crlab3/OBD_IONRF_ESP32/OBDESP/OBDESP.dxf

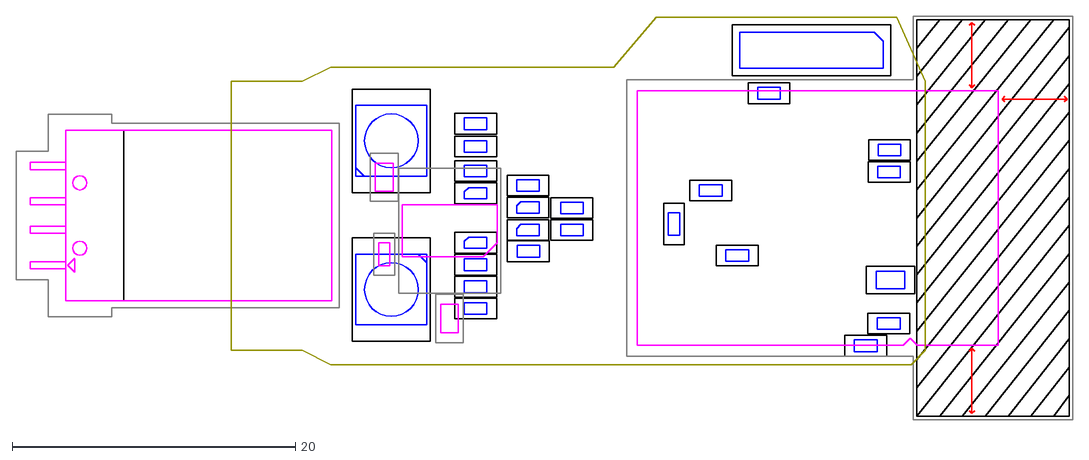
[picture p1: CAD file, 2022-12-18]
OBDESP/OBDESP.dxf
74.6 x 28.5
