crlab3/OBD_IONRF_ESP32/Manufacturing.xlsx

Sheet: ESP32-OBD
Tétel neve | Szükséges darabszám | Forrás | Link | Ár (nettó) | Ár (bruttó) | Szállítási díj
Alapalkatrészek | 1 | LOMEX |  |  | 2500 | 2200
ELM327 OBD olvasó | 1 | Peppi.hu | https://peppi.hu/products/obd2-hibakod-olvaso?variant=6866871943229&currency=HUF |  | 3400 | 2000
USB Szivargyújtó töltő | 1 | Aqua.hu | https://aqua.hu/mobiltelefon-kiegeszito/baseus-grain-autos-tolto-2x-usb-31a-fekete-ccall-ml01-t1167436 |  | 1220 | 2000
ESP32-WROOM Modul | 1 | Mouser | https://hu.mouser.com/ProductDetail/Espressif-Systems/ESP32-WROOM-32E-H4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 |  | 1340 | 1000
Nyomtatott áramköri lap | 1x6 | Aisler | Aisler.net - Blitz, UPS standard |  | 1700 | 5600
USB-ház (Hammond) | 1 | Mouser | https://hu.mouser.com/ProductDetail/Hammond-Manufacturing/1551USB3CLR?qs=UqPySVGgRwHUcGN5q%252B3ujQ%3D%3D |  | 1250 | 2000
 |  |  |  |  | 68460 | 14800
 |  |  |  |  | 6 db teljes ára | ár/db (6 db-ra vetítve) | 30 db ára
 |  |  |  |  | 83260 | 13876.66667 Ft | 357100
 |  |  |  | Munkadíj | 10000 Ft | 10000 Ft

Sheet: ESP32-OBD with IO-NRF
Tétel neve | Szükséges darabszám | Forrás | Link | Ár (nettó) | Ár (bruttó) | Szállítási díj
Alapalkatrészek | 1 | LOMEX |  |  | 2500 | 2200
ELM327 OBD olvasó | 1 | Peppi.hu | https://peppi.hu/products/obd2-hibakod-olvaso?variant=6866871943229&currency=HUF |  | 3400 | 2000
USB Szivargyújtó töltő | 1 | Aqua.hu | https://aqua.hu/mobiltelefon-kiegeszito/baseus-grain-autos-tolto-2x-usb-31a-fekete-ccall-ml01-t1167436 |  | 1220 | 2000
ESP32-WROOM Modul | 1 | Mouser | https://hu.mouser.com/ProductDetail/Espressif-Systems/ESP32-WROOM-32E-H4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 |  | 1340 | 1000
Nyomtatott áramköri lap | 1x6 | Aisler | Aisler.net - Blitz, UPS standard |  | 1700 | 5600
USB-ház (Hammond) | 1 | Mouser | https://hu.mouser.com/ProductDetail/Hammond-Manufacturing/1551USB3CLR?qs=UqPySVGgRwHUcGN5q%252B3ujQ%3D%3D |  | 1250 | 2000
NRF24L01 | 1 | techfun.sk | NRF24L01 (6 db) |  | 757 | 1915
 |  |  |  |  | 73002 | 16715
 |  |  |  |  | 6 db teljes ára | ár/db (1 db-ra vetítve) | 30 db-ra
 |  |  |  |  | 89717 | 14952.83 Ft | 381725
 |  |  |  | Munkadíj | 10000 Ft | 10000 Ft

Sheet: IO-NRF_minimal (6 db)
Tétel neve | Szükséges darabszám | Forrás | Link | Ár (nettó) | Ár (bruttó) | Szállítási díj
Alapalkatrészek | 1 | LOMEX | Mindenből 5 helyett 6 db a tartalék miatt. | 6936 | 8808.72 | 2200
Alapalkatrészek | 1 | Mouser.com | AP7370-33W-7, 556-ATTINY84-20SSUR |  | 6238 | 1500
NRF24L01 + XKC-Y25-NPN | 1 | techfun.sk | NRF24L01 + XKC-Y25-L01 |  | 37185 | 0
NRF24L01 + XKC-Y25-NPN | 1 | eBay | NRF24L01 (4767 Ft) + XKC-Y25-NPN (21600 Ft) |  | 26366 | 0
NRF24L01 + XKC-Y25-NPN | 1 | TechFun.sk, HEStore | NRF24L01 (4540 Ft) + XKC-Y25-NPN (24000 Ft) |  | 28540 | 1915
Nyomtatott áramköri lap | 1 x 6PCs | Aisler (Budget) | Aisler.net |  | 5127 | 0
Nyomtatott áramköri lap | 1 x 6PCs | Aisler (Blitz) | Aisler.net |  | 10254 | 5530
Inline Blade Fuse Holder | 1 | FDH | Multicomp MP001005 + TLP291 | 12332 | 15661.64 | 0
 |  |  |  |  |  |  | ár/db | ár/db | ár/db 30 db-ra
 |  |  |  |  |  |  | 2-hét alatt (Aisler Blitz) | 4-hét alatt (Aisler Budget) | 2-hét alatt (Aisler Blitz)
 |  |  |  |  |  |  | 13441.2 Ft | 11665.1 Ft | 11955.2 Ft
 |  |  |  |  |  | Munkadíj | 10000 Ft | 10000 Ft

Sheet: Beültetési árak
Név | Darabszám | Gyártó | Méret | Ajánlott ár | Ajánlott ár/db | EUR2HUF | Ár/db | Végösszeg
22 SMT, 13 Unique, Single sided
IO-NRF minimal (THT) | 30 | Aisler | 52x33 | 267.55 € | 8.92 € | 395.0 Ft | 3522.7 Ft | 105682.2 Ft
IO-NRF minimal (NO-THT) | 30 | Aisler | 52x33 | 161.55 € | 5.39 € | 395.0 Ft | 2127.1 Ft | 63812.3 Ft
35 SMT, 21 Unique, Double sided
OBDESP32 (NOTHT) | 30 | Aisler | 57x26 | 340.89 € | 11.36 € | 395.0 Ft | 4488.4 Ft | 134651.6 Ft
OBDESP32 (NOTHT) | 20 | Aisler | 57x26 | 323.93 € | 16.20 € | 395.0 Ft | 6397.6 Ft | 127952.4 Ft
OBDESP32 (NOTHT) | 10 | Aisler | 57x26 | 306.96 € | 30.70 € | 395.0 Ft | 12124.9 Ft | 121249.2 Ft

Sheet: Összesítő 30 db
Tétel név | Alkatrészek + NYÁKgyártás | Beültetés (AISLER, EUR) | Beültetés (AISLER, HUF) | EUR2HUF | Végösszeg (beültetéssel) | Végösszeg/db (beültetéssel) | Végösszeg (beültetés nélkül) | Végösszeg/db (beültetés nélkül)
IO-NRF minimal | 358656.6 Ft | 161.55 € | 63812.25 Ft | 395 | 422468.85 Ft | 14082.30 Ft | 358656.6 Ft | 11955.22 Ft
OBD-ESP32 with IO-NRF | 381725.0 Ft | 340.89 € | 134651.55 Ft | 395 | 516376.55 Ft | 17212.55 Ft | 381725.0 Ft | 12724.17 Ft
OBD-ESP32 only | 357100.0 Ft | 340.89 € | 134651.55 Ft | 395 | 491751.55 Ft | 16391.72 Ft | 357100.0 Ft | 11903.33 Ft
darabszám | 30
