crlab3/OBD_IONRF_ESP32/IO_NRF_minimal/IO_NRF_minimal.kicad_pcb

## KiCad design IO_NRF_minimal/IO_NRF_minimal.kicad_pcb (2023-07-27)

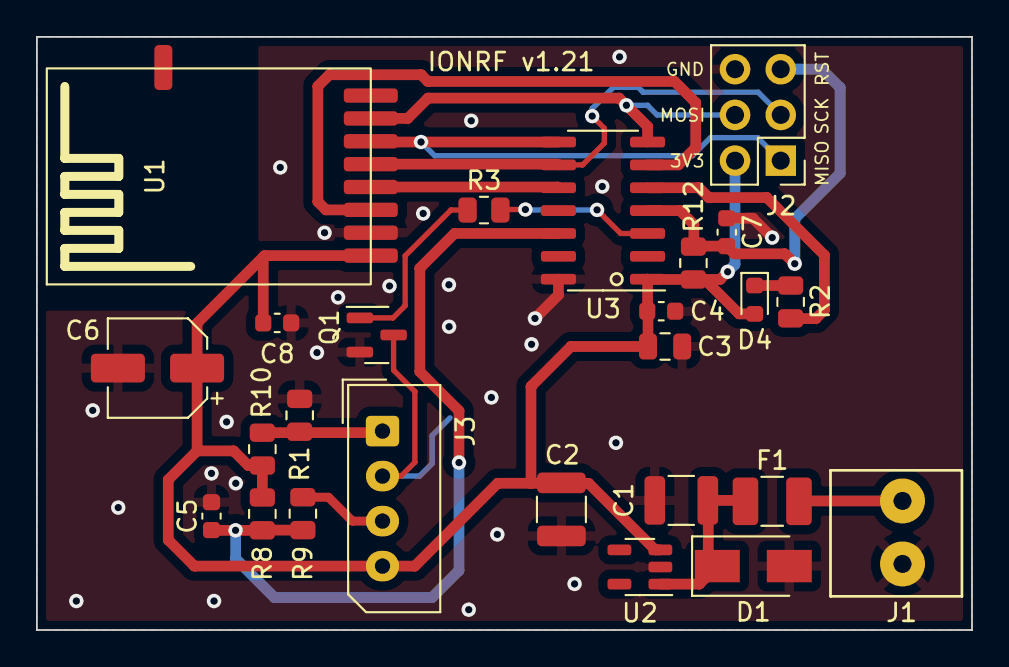
[picture p2: board IO_NRF_minimal.kicad_pcb from above]

Board: 2 copper layers, 52.0 x 33.0 mm, 26 parts (1 on the bottom side), 18 nets.

Parts:
C1, C2: 10uF; C_1210_3225Metric
C3: 4.7uF; C_0805_2012Metric
C4, C5, C7, C8: 100nF; C_0603_1608Metric
C6: 100uF; CP_Elec_5x5.3
D1: DO-214AC; D_SMA
D4: LED; LED_0603_1608Metric
F1: 100mA Polyfuse; Fuse_1210_3225Metric_Pad1.42x2.65mm_HandSolder
J1: 12V_IN; SORKAPOCS-3.5mm-2
J2: Programmer_Pins_SPI; PinHeader_2x03_P2.54mm_Vertical
J3: XKC-Y2S-IN; Molex_SPOX_5267-04A_1x04_P2.50mm_Vertical
JP1: SolderJumper_2_Open; SolderJumper-2_P1.3mm_Open_RoundedPad1.0x1.5mm
Q1: BC847B; SOT-23
R1, R2, R3, R8, R9, R10, R12: 1k; R_0805_2012Metric
U1: NRF24L01_SMD
U2: AP7370-33WW-7; SOT-23-5
U3: ATtiny84-20SS; SOIC-14_3.9x8.7mm_P1.27mm

Connections:
/3V3: C2.1, C3.1, C4.1, C6.1, C8.2, D4.2 (A), J2.2, J3.4, R8.1, R10.1, R12.1, U1.1 (3V3), U2.3 (VOUT(3.3V)), U3.1 (VCC)
/ACC_12V_IN: F1.2, J1.2
/ACC_12V_PROT: C1.1, D1.1 (K), F1.1, U2.1 (VIN)
/MCU_MISO: J2.1, U1.6 (MOSI), U3.8 (PA5)
/MCU_MOSI: J2.4, U1.7 (MISO), U3.7 (PA6)
/MCU_RESET: C7.2, J2.5, R12.2, U3.4 (~RESET/PB3)
/MCU_SCK: J2.3, U1.5 (SCK), U3.9 (PA4)
/NRF_CE: U1.3 (CE), U3.6 (PA7)
/NRF_CS: U1.4 (CSN), U3.10 (PA3)
/XKC-Y2S-IN: C5.2, R8.2, R9.2, U3.12 (PA1)
/XKC_ACTIVATE: R3.2, U3.3 (XTAL2/PB1)
GND: C1.2, C2.2, C3.2, C4.2, C5.1, C6.2, C7.1, C8.1, D1.2 (A), J1.1, J2.6, JP1.1 (A), Q1.2 (E), R1.1, U1.2 (GND), U2.2 (GND), U3.14 (GND)
unnamed: D4.1 (K), R2.1
unnamed: J3.1, R1.2, R10.2
unnamed: J3.2, JP1.2 (B), Q1.3 (C)
unnamed: J3.3, R9.1
unnamed: Q1.1 (B), R3.1
unnamed: R2.2, U3.5 (PB2)
