crlab3/OBD_IONRF_ESP32/OBDESP/OBDESP.kicad_pcb

## KiCad design OBDESP/OBDESP.kicad_pcb (2023-07-27)

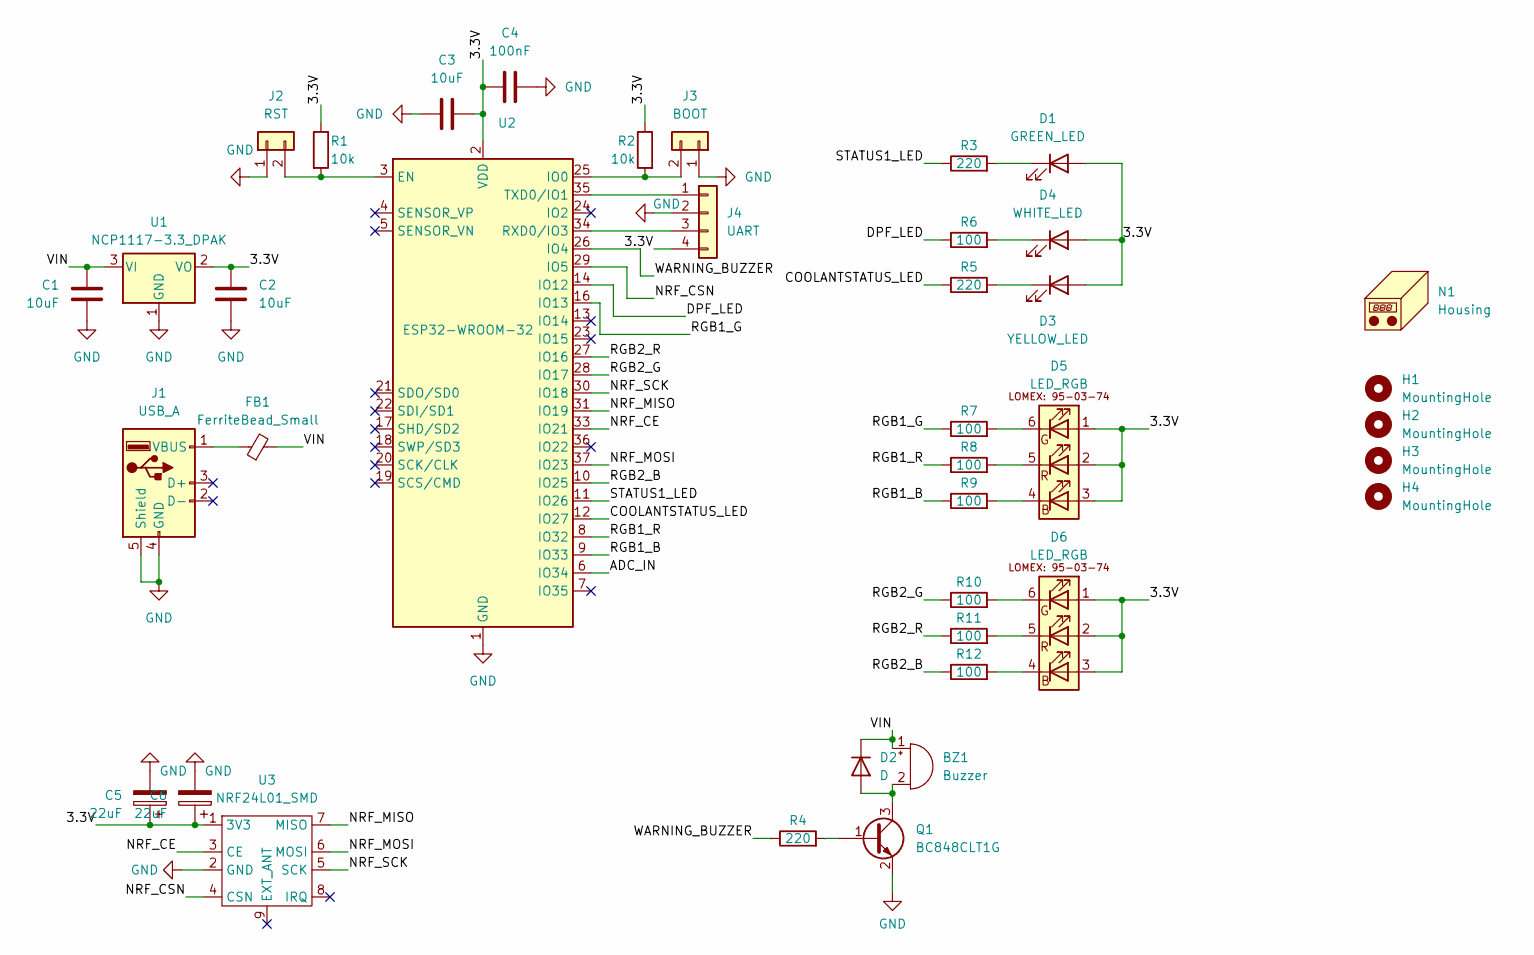
[picture p3: schematic OBDESP.kicad_sch]

Parts:
BZ1: Buzzer; PUIAudio_SMT_0825_S_4_R; Mouser 490-CMT-7525-80SMTTR
C1, C2, C3: 10uF; C_0805_2012Metric
C4: 100nF; C_0603_1608Metric
C5, C6: 22uF; CP_EIA-3216-18_Kemet-A
D1: GREEN_LED; LED_0603_1608Metric
D2: D; D_SMA
D3: YELLOW_LED; LED_0603_1608Metric
D4: WHITE_LED; LED_0603_1608Metric
D5, D6: LED_RGB; LED_RGB_5050-6
FB1: FerriteBead_Small; L_0603_1608Metric
H1, H2, H3, H4: MountingHole; MountingHole_2.2mm_M2_DIN965
J1: USB_A; USB_A_CNCTech_1001-011-01101_Horizontal
J2: RST; B3U-1000P_Button; Mouser 611-PTS636SK25SMTRLF
J3: BOOT; B3U-1000P_Button; Mouser 611-PTS636SK25SMTRLF
J4: UART; PinHeader_1x04_P2.54mm_Vertical
N1: Housing; Farnell 2580590
Q1: BC848CLT1G; SOT-23
R1, R2: 10k; R_0603_1608Metric
R3, R4, R5: 220; R_0603_1608Metric
R6, R7, R8, R9, R10, R11, R12: 100; R_0603_1608Metric
U1: NCP1117-3.3_DPAK; SOT-223-3_TabPin2
U2: ESP32-WROOM-32; ESP32-WROOM-32U; Mouser 356-ESP32WRM32E164PH
U3: NRF24L01_SMD

Connections:
/3.3V: C2.2, C3.1, C4.1, C5.1, C6.1, D1.2 (A), D3.2 (A), D4.2 (A), D5.1 (RA), D5.2 (GA), D5.3 (BA), D6.1 (RA), D6.2 (GA), D6.3 (BA), J4.4, R1.1, R2.1, U1.2 (VO), U2.2 (VDD), U3.1 (3V3)
/ADC_IN: U2.6 (IO34)
/COOLANTSTATUS_LED: R5.1, U2.12 (IO27)
/DPF_LED: R6.1, U2.14 (IO12)
/NRF_CE: U2.33 (IO21), U3.3 (CE)
/NRF_CSN: U2.29 (IO5), U3.4 (CSN)
/NRF_MISO: U2.31 (IO19), U3.7 (MISO)
/NRF_MOSI: U2.37 (IO23), U3.6 (MOSI)
/NRF_SCK: U2.30 (IO18), U3.5 (SCK)
/RGB1_B: R9.1, U2.9 (IO33)
/RGB1_G: R7.1, U2.16 (IO13)
/RGB1_R: R8.1, U2.8 (IO32)
/RGB2_B: R12.1, U2.10 (IO25)
/RGB2_G: R10.1, U2.28 (IO17)
/RGB2_R: R11.1, U2.27 (IO16)
/STATUS1_LED: R3.1, U2.11 (IO26)
/VIN: BZ1.1 (-), C1.2, D2.1 (K), FB1.2, U1.3 (VI)
/WARNING_BUZZER: R4.1, U2.26 (IO4)
GND: C1.1, C2.1, C3.2, C4.2, C5.2, C6.2, J1.4 (GND), J1.5 (Shield), J2.1, J3.1, J4.2, Q1.2 (E), U1.1 (GND), U2.1 (GND), U2.15 (GND), U2.38 (GND), U2.39 (GND), U3.2 (GND)
unnamed: BZ1.2 (+), D2.2 (A), Q1.3 (C)
unnamed: D1.1 (K), R3.2
unnamed: D5.4 (BK), R9.2
unnamed: D5.5 (GK), R8.2
unnamed: D5.6 (RK), R7.2
unnamed: D6.4 (BK), R12.2
unnamed: D6.5 (GK), R11.2
unnamed: D6.6 (RK), R10.2
unnamed: FB1.1, J1.1 (VBUS)
unnamed: J2.2, R1.2, U2.3 (EN)
unnamed: J3.2, R2.2, U2.25 (IO0)
unnamed: J4.1, U2.35 (TXD0/IO1)
unnamed: J4.3, U2.34 (RXD0/IO3)
unnamed: Q1.1 (B), R4.2
unnamed: D3.1 (K), R5.2
unnamed: D4.1 (K), R6.2

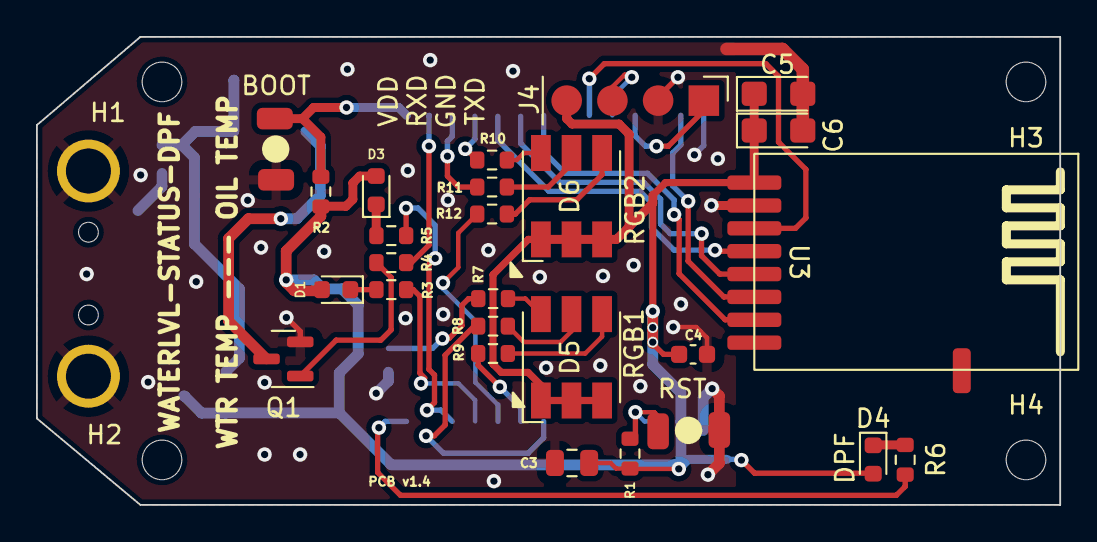
[picture p4: board OBDESP.kicad_pcb from above]

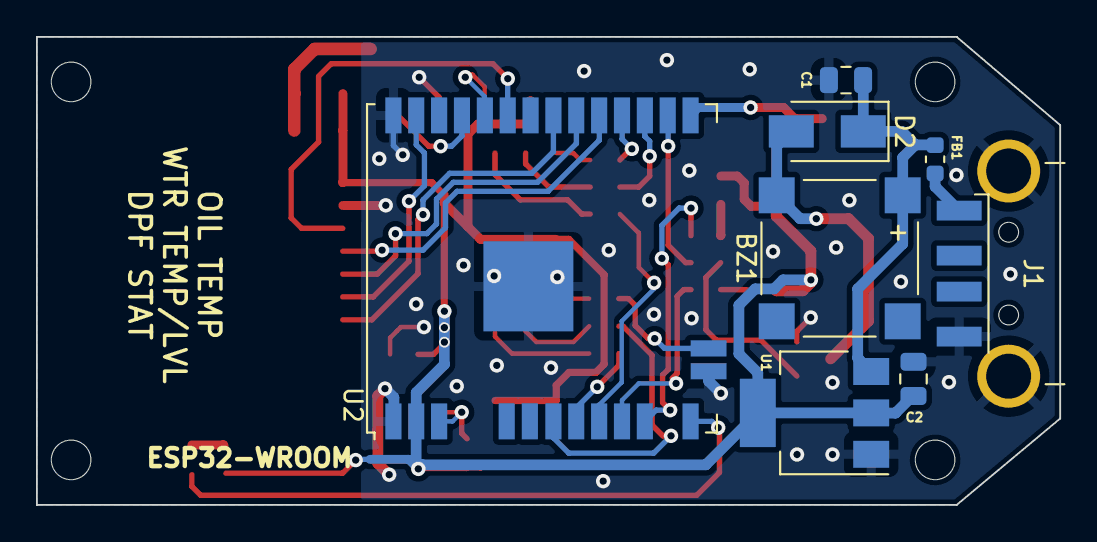
[picture p5: board OBDESP.kicad_pcb from below]

Board: 2 copper layers, 56.8 x 26.0 mm, 38 parts (8 on the bottom side), 34 nets.
