crlab3/OBD_IONRF_ESP32/IO_NRF/IO_NRF.kicad_pcb

## KiCad design IO_NRF/IO_NRF.kicad_pcb (2022-12-31)

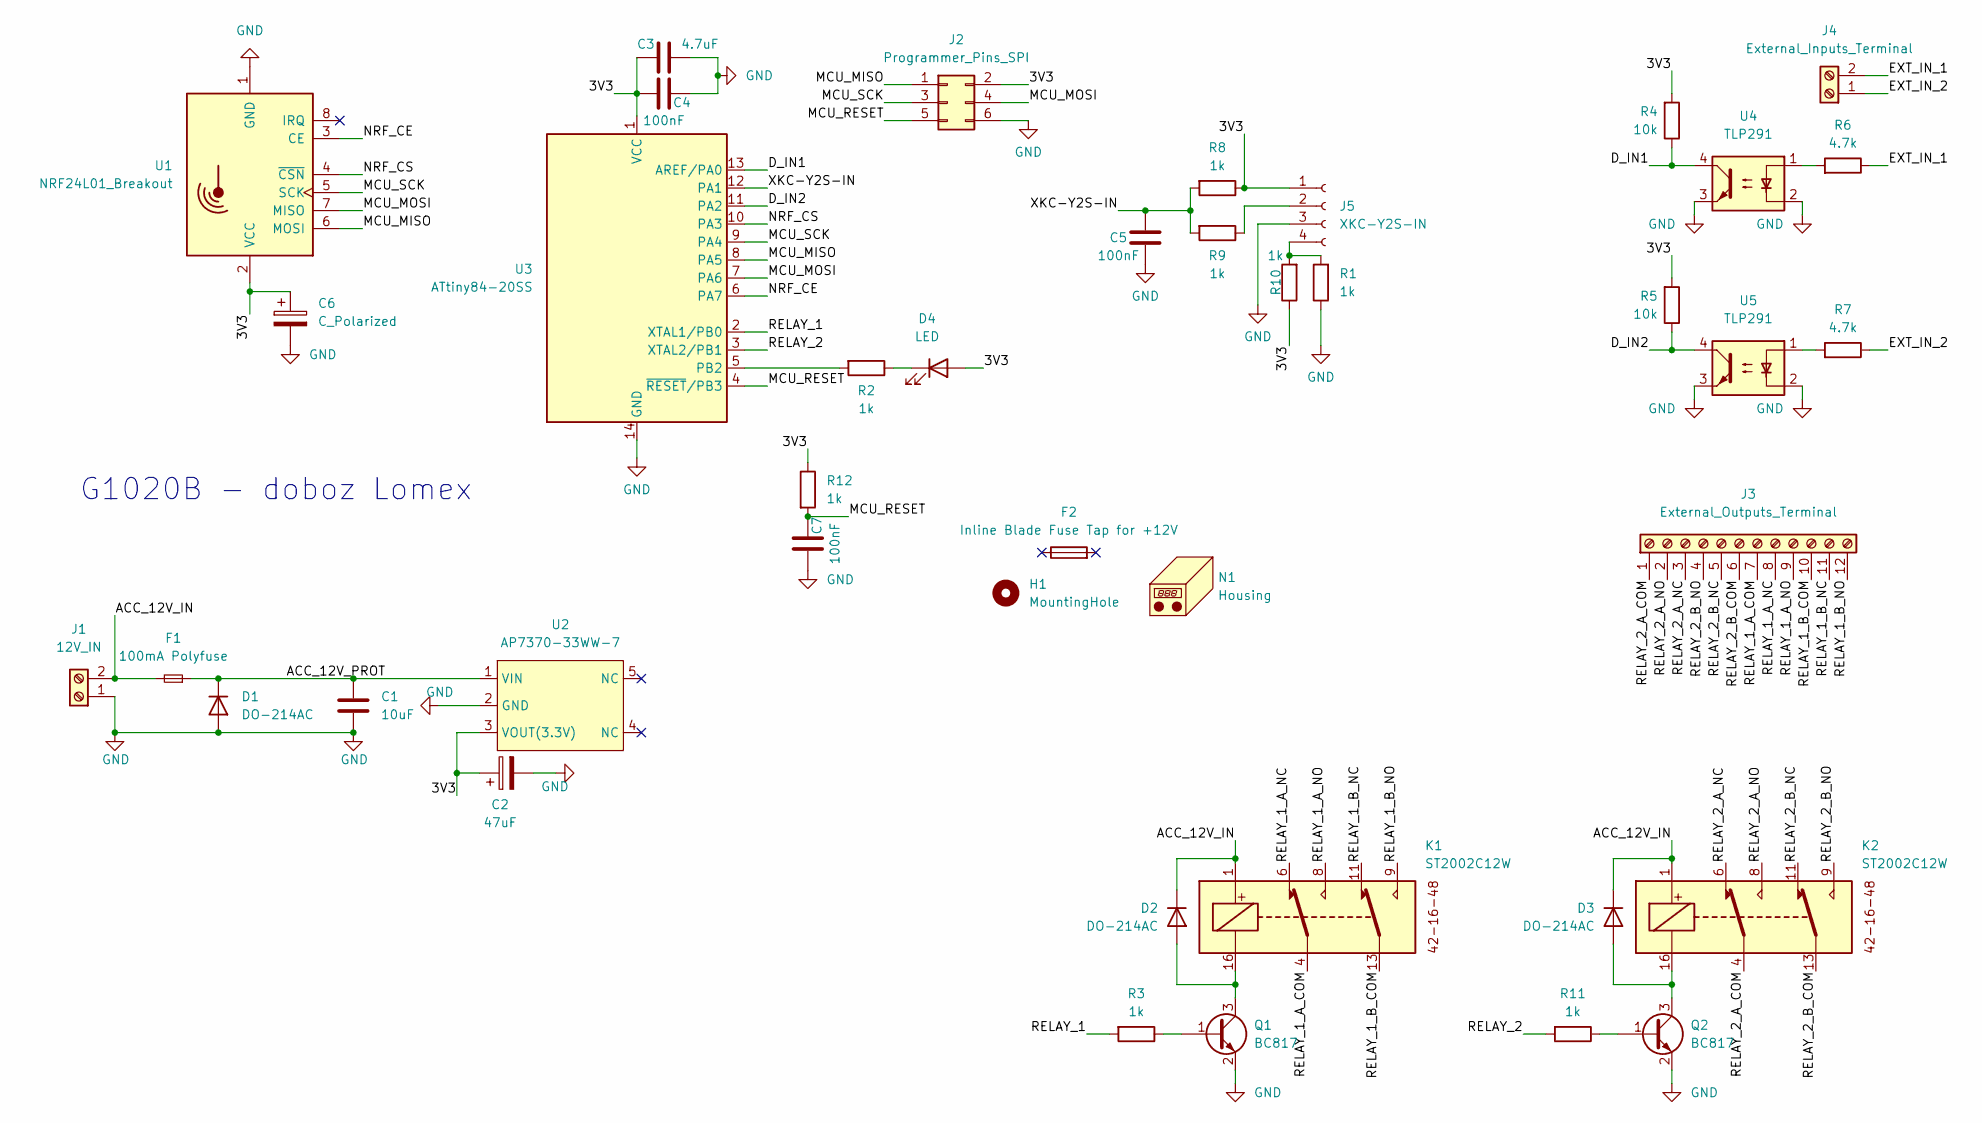
[picture p6: schematic IO_NRF.kicad_sch]

Parts:
C1: 10uF; C_1210_3225Metric
C2: 47uF; CP_Elec_6.3x5.4
C3: 4.7uF; C_0805_2012Metric
C4, C5, C7: 100nF; C_0603_1608Metric
C6: C_Polarized; CP_Elec_5x5.3
D1, D2, D3: DO-214AC; D_SMA
D4: LED; LED_0603_1608Metric
F1: 100mA Polyfuse; Fuse_1210_3225Metric_Pad1.42x2.65mm_HandSolder
F2: Inline Blade Fuse Tap for +12V; Farnell 3227155
H1: MountingHole; MountingHole_3.2mm_M3
J1: 12V_IN; SORKAPOCS-3.5mm-2
J2: Programmer_Pins_SPI; PinHeader_2x03_P2.54mm_Vertical
J3: External_Outputs_Terminal; SORKAPOCS-3.5mm-12
J4: External_Inputs_Terminal; SORKAPOCS-3.5mm-2
J5: XKC-Y2S-IN; PinSocket_1x04_P2.54mm_Vertical
K1, K2: ST2002C12W
N1: Housing
Q1, Q2: BC817; SOT-23
R1, R2, R3, R8, R9, R10, R11, R12: 1k; R_0805_2012Metric
R4, R5: 10k; R_0805_2012Metric
R6, R7: 4.7k; R_0805_2012Metric
U1: NRF24L01_Breakout; PinHeader_2x04_P2.54mm_Vertical
U2: AP7370-33WW-7; SOT-23-5; Mouser 621-AP7370-33WW-7
U3: ATtiny84-20SS; SOIC-14_3.9x8.7mm_P1.27mm; Mouser 556-ATTINY84-20SSUR
U4, U5: TLP291; SOIC-4_4.55x2.6mm_P1.27mm

Connections:
/3V3: C2.1, C3.1, C4.1, C6.1, D4.2 (A), J2.2, J5.1, R4.2, R5.2, R8.1, R10.1, R12.1, U1.2 (VCC), U2.3 (VOUT(3.3V)), U3.1 (VCC)
/ACC_12V_IN: D2.1 (K), D3.1 (K), F1.2, J1.2, K1.1, K2.1
/ACC_12V_PROT: C1.1, D1.1 (K), F1.1, U2.1 (VIN)
/D_IN1: R4.1, U3.13 (AREF/PA0), U4.4
/D_IN2: R5.1, U3.11 (PA2), U5.4
/EXT_IN_1: J4.2, R6.1
/EXT_IN_2: J4.1, R7.1
/MCU_MISO: J2.1, U1.6 (MOSI), U3.8 (PA5)
/MCU_MOSI: J2.4, U1.7 (MISO), U3.7 (PA6)
/MCU_RESET: C7.2, J2.5, R12.2, U3.4 (~RESET/PB3)
/MCU_SCK: J2.3, U1.5 (SCK), U3.9 (PA4)
/NRF_CE: U1.3 (CE), U3.6 (PA7)
/NRF_CS: U1.4 (~CSN), U3.10 (PA3)
/RELAY_1: R3.2, U3.2 (XTAL1/PB0)
/RELAY_1_A_COM: J3.7, K1.4
/RELAY_1_A_NC: J3.8, K1.6
/RELAY_1_A_NO: J3.9, K1.8
/RELAY_1_B_COM: J3.10, K1.13
/RELAY_1_B_NC: J3.11, K1.11
/RELAY_1_B_NO: J3.12, K1.9
/RELAY_2: R11.2, U3.3 (XTAL2/PB1)
/RELAY_2_A_COM: J3.1, K2.4
/RELAY_2_A_NC: J3.3, K2.6
/RELAY_2_A_NO: J3.2, K2.8
/RELAY_2_B_COM: J3.6, K2.13
/RELAY_2_B_NC: J3.5, K2.11
/RELAY_2_B_NO: J3.4, K2.9
/XKC-Y2S-IN: C5.2, R8.2, R9.2, U3.12 (PA1)
GND: C1.2, C2.2, C3.2, C4.2, C5.1, C6.2, C7.1, D1.2 (A), J1.1, J2.6, J5.3, Q1.2 (E), Q2.2 (E), R1.1, U1.1 (GND), U2.2 (GND), U3.14 (GND), U4.2, U4.3, U5.2, U5.3
unnamed: D2.2 (A), K1.16, Q1.3 (C)
unnamed: D3.2 (A), K2.16, Q2.3 (C)
unnamed: D4.1 (K), R2.1
unnamed: J5.2, R9.1
unnamed: J5.4, R1.2, R10.2
unnamed: Q1.1 (B), R3.1
unnamed: Q2.1 (B), R11.1
unnamed: R2.2, U3.5 (PB2)
unnamed: R6.2, U4.1
unnamed: R7.2, U5.1

Notes on the sheet:
G1020B - doboz Lomex

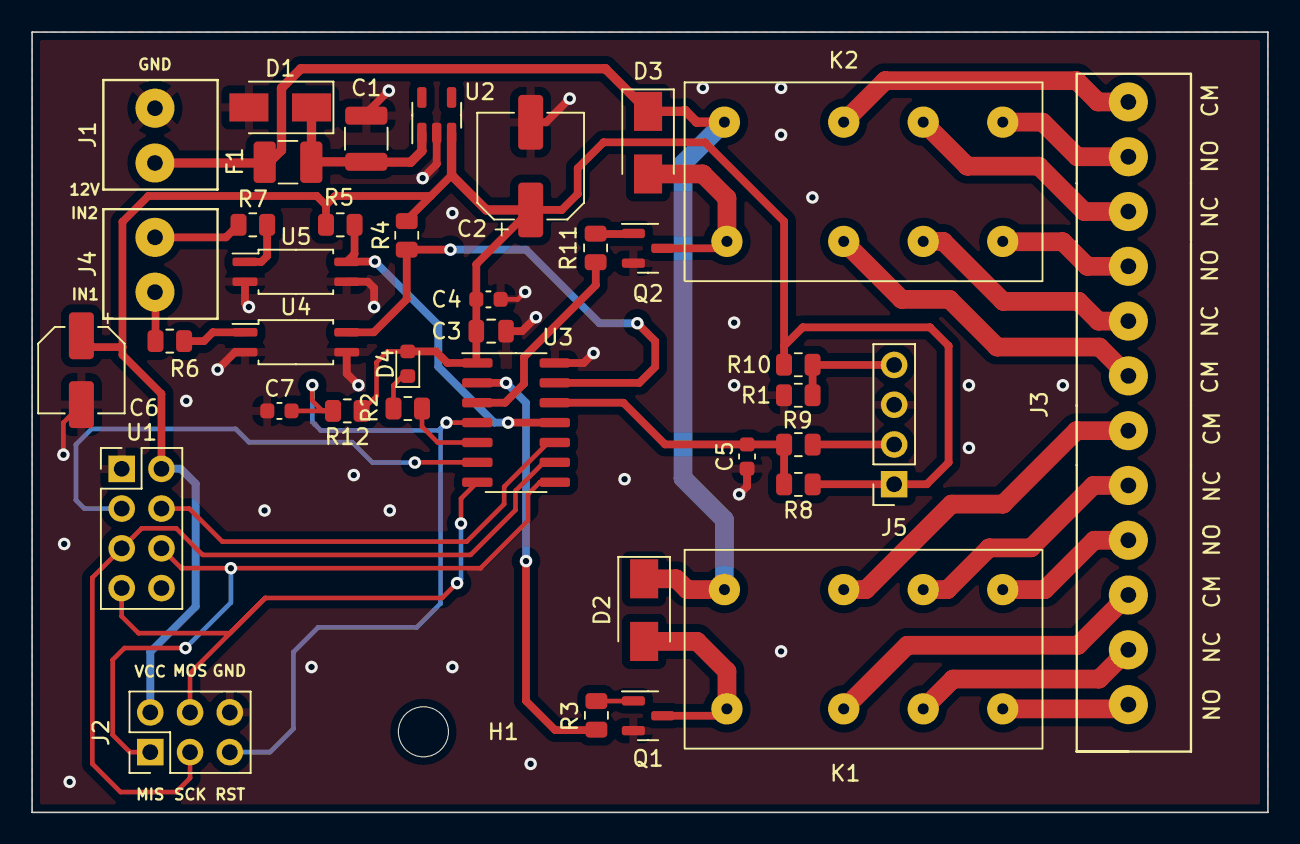
[picture p7: board IO_NRF.kicad_pcb from above]

Board: 2 copper layers, 79.0 x 49.9 mm, 39 parts (0 on the bottom side), 39 nets.
