crlab3/OBD_IONRF_ESP32/(commit log)

2022-12-18 Initial commit 1
    New commit for repo
    [IO_NRF.kicad_pcb, IO_NRF.kicad_sch, OBDESP.dxf, OBDESP.kicad_pcb, OBDESP.kicad_sch]
2022-12-31 NRF24L01 Communicating on ESP32 & ATTINY84
    IONRF + ESP32 for NRF24L01 TESTED OK.
    PCBs are fixed.
    [IO_NRF.kicad_pcb, IO_NRF.kicad_sch]
2023-01-01 Fixed RGD Red TONE at ESP32, IONRF sending live data OK
    [ESP32.ino, IONRF.ino]
2023-01-02 IONRF: millis() implemented
2023-01-02 ESP32 - New millis() timer, coolant level sense OK, test SW 1.0
    Everything works fine in car! Testing start now!
2023-01-06 fixed heatmap, left-right LED, now testing millis() cycle
    [ESP32.ino]
2023-01-06 Timing working OK, ELM errors tested OK, Release 1.0
    [ESP32.ino]
2023-01-06 Started manufacturing data collection
    [Manufacturing.xlsx]
2023-01-07 Updated ODBESP32 PCB with LED separation larger.
    [OBDESP.kicad_pcb]
2023-01-07 deleted PCB 3D OBDESP32 file
2023-01-08 Updated manufacturing xls
    [IO_NRF_minimal.kicad_pcb, IO_NRF_minimal.kicad_sch, Manufacturing.xlsx]
2023-01-13 Updated both PCBs with TEMT6000 and XKC enabler
    [IO_NRF_minimal.kicad_pcb, IO_NRF_minimal.kicad_sch, OBDESP.kicad_pcb, OBDESP.kicad_sch]
2023-01-13 ESP32-added ADC functions untested! PCB update
    added capacitor for PCB design for ADC reading the TEMT6000 sensor
    [OBDESP.kicad_pcb, OBDESP.kicad_sch]
2023-01-14 Minimalized IO-NRF, no Digital Input
    [IO_NRF_minimal.kicad_pcb, IO_NRF_minimal.kicad_sch, Manufacturing.xlsx]
2023-01-14 Updated BOMs, manufacturing (beültetés árak) and PCBs
    [IO_NRF_minimal.kicad_pcb, IO_NRF_minimal.kicad_sch, Manufacturing.xlsx]
2023-01-15 Uploaded codes to IONRF (Watchdog) & ESP32 now testing
2023-01-21 added bom-on kivuli list
2023-01-21 minimal xls update
    f
    [OBDESP.kicad_sch, OBDESP32_NRF.xlsx]
2023-01-24 Updated ESP32 software to support new OBDII types as well as previous types
2023-07-27 latest versions
    [IO_NRF_minimal.kicad_pcb, IO_NRF_minimal.kicad_sch, OBDESP.kicad_pcb, OBDESP.kicad_sch]
2023-07-27 Light sensor parts eliminated from code. DEBUG_PORT - Off.
